GabrielLueneberg/balanceBot/CAD/Arquivos impressão/Orientação de impressão/Bases.png

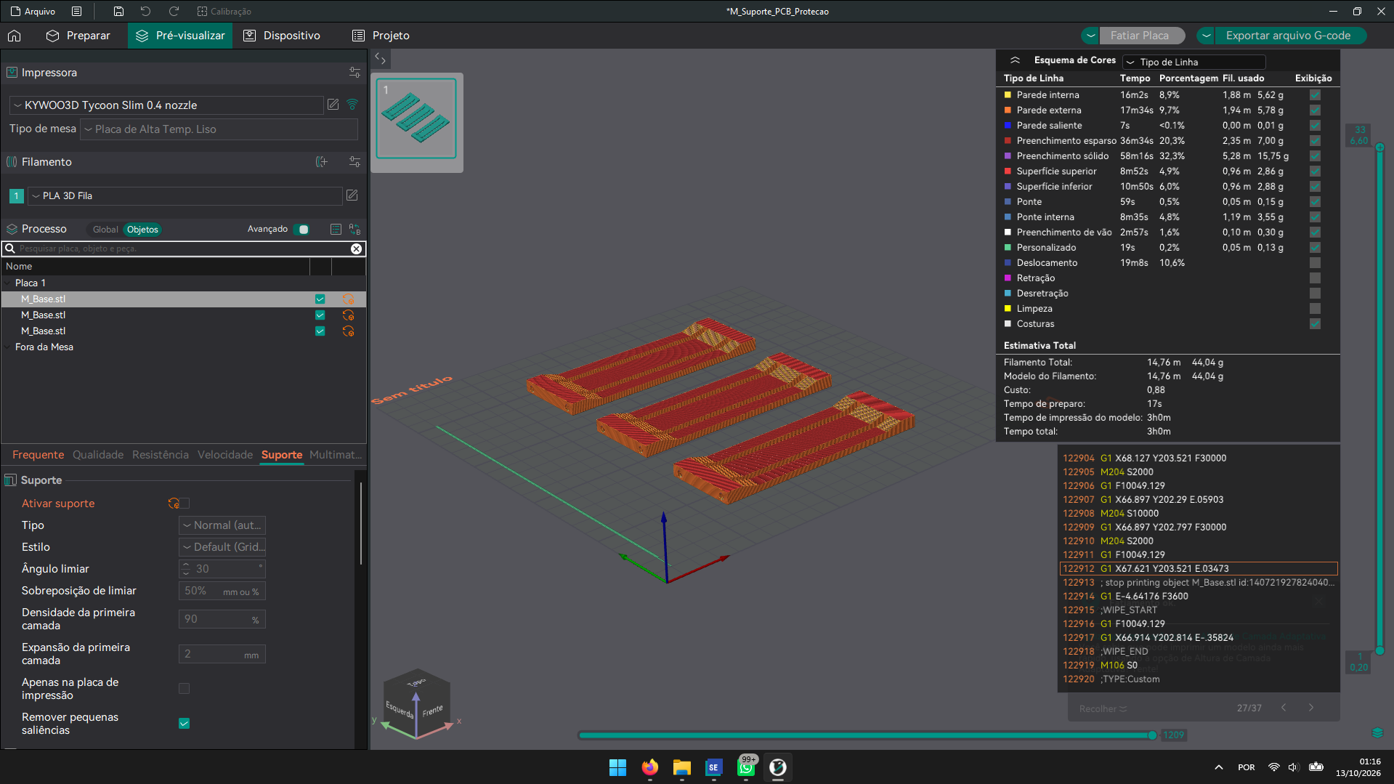
CAD/Arquivos impressão/Orientação de impressão/Bases.png
