GabrielLueneberg/balanceBot/CAD/Arquivos impressão/Orientação de impressão/Rodas e Laterais.png

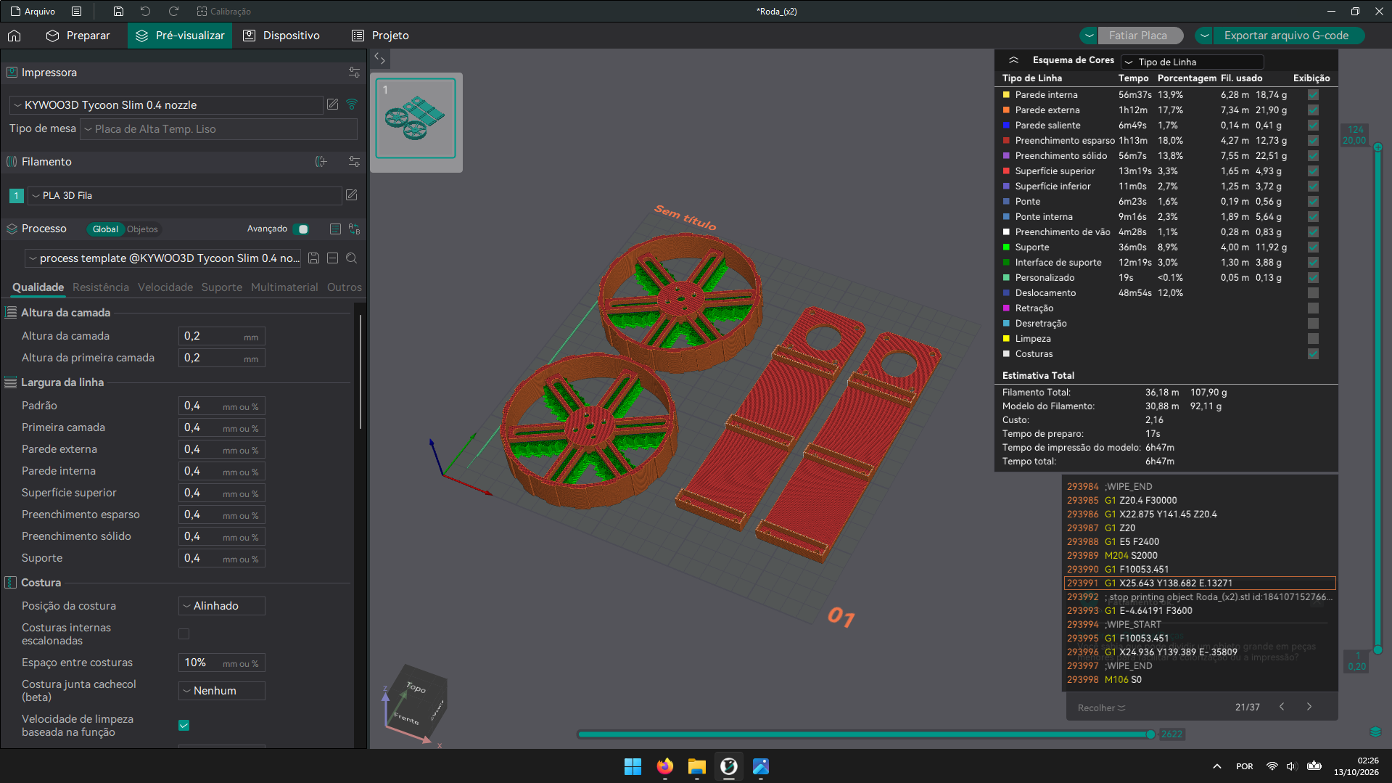
CAD/Arquivos impressão/Orientação de impressão/Rodas e Laterais.png
