GabrielLueneberg/balanceBot/CAD/Arquivos impressão/Orientação de impressão/Suporte e Suporte Com Proteção.png

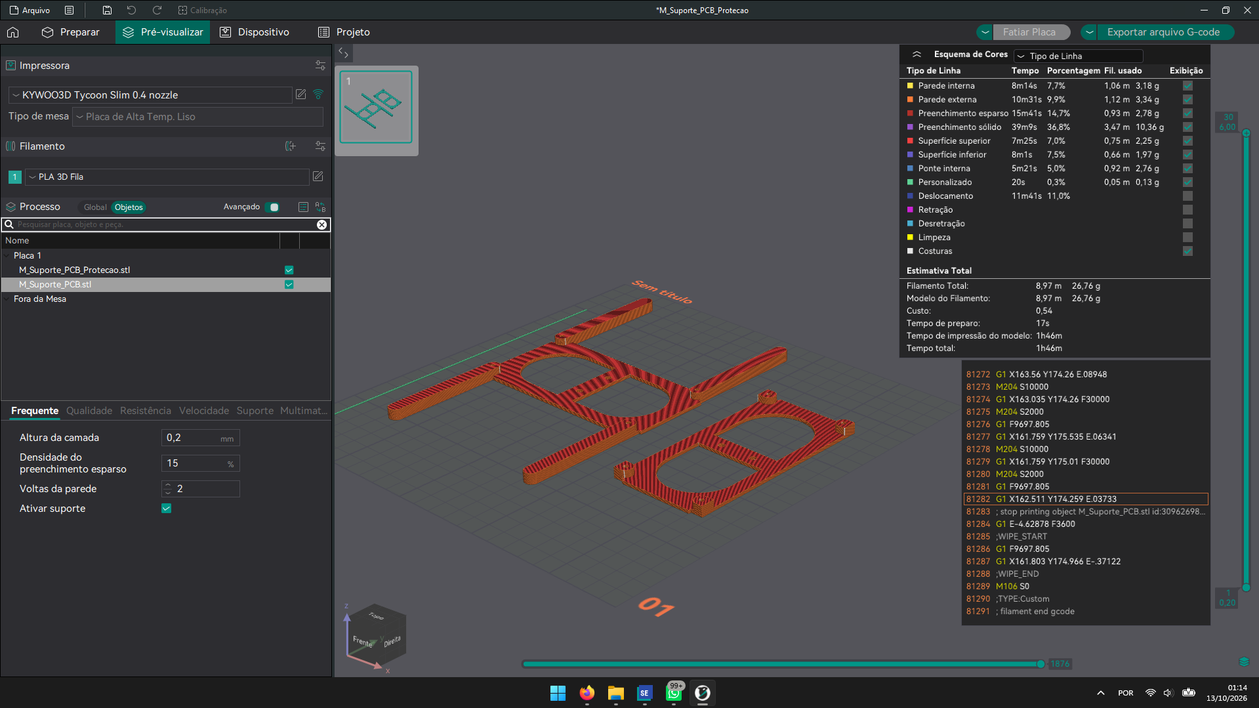
CAD/Arquivos impressão/Orientação de impressão/Suporte e Suporte Com Proteção.png
