GabrielLueneberg/balanceBot/CAD/Arquivos impressão/Arquivos STL/Roda_(x2).stl

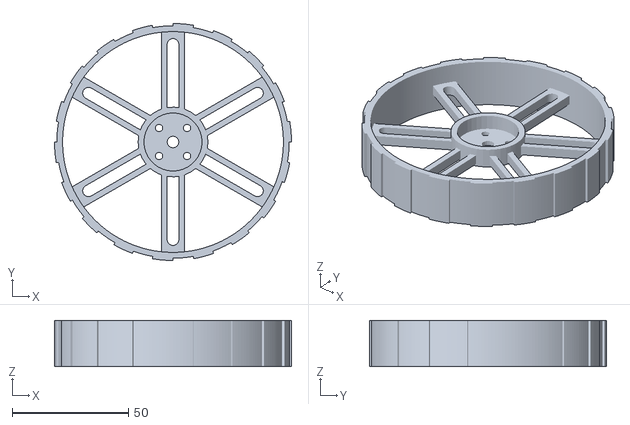
[picture p6: CAD file, 2026-11-04]
CAD/Arquivos impressão/Arquivos STL/Roda_(x2).stl
102.0 x 102.0 x 20.0
