GabrielLueneberg/balanceBot/CAD/Arquivos impressão/Arquivos STL/Lateral_(x2).stl

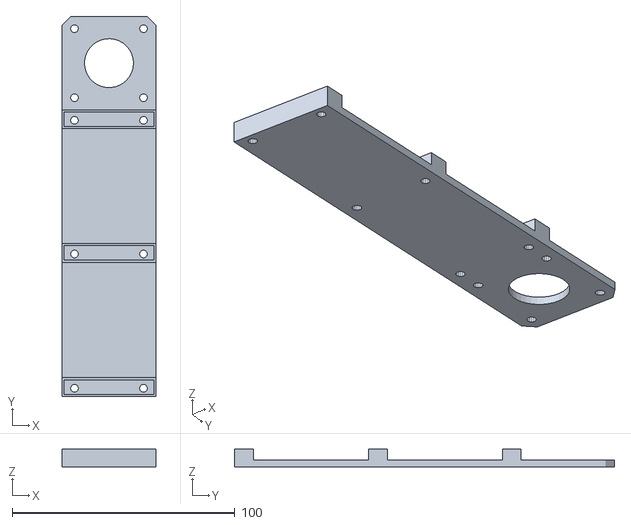
[picture p7: CAD file, 2026-11-04]
CAD/Arquivos impressão/Arquivos STL/Lateral_(x2).stl
42.3 x 170.7 x 8.00
