GabrielLueneberg/balanceBot/CAD/Arquivos impressão/Arquivos STL/Suporte_com_Protecao_(x1).stl

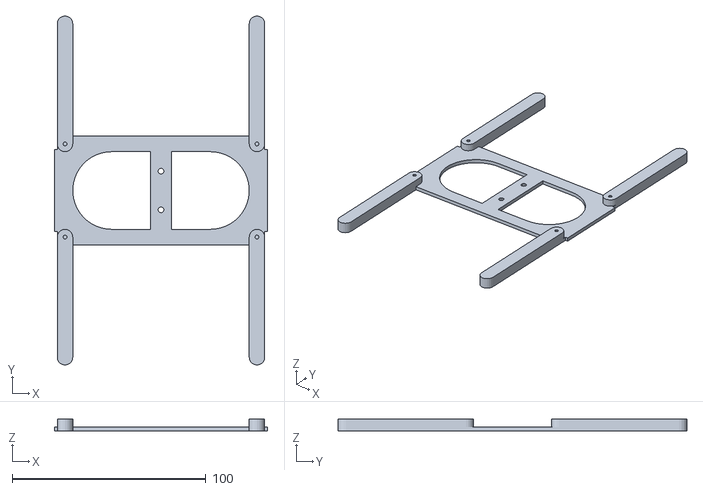
[picture p8: CAD file, 2026-11-04]
CAD/Arquivos impressão/Arquivos STL/Suporte_com_Protecao_(x1).stl
110.0 x 180.0 x 6.00
