GabrielLueneberg/balanceBot/CAD/Arquivos impressão/Arquivos STL/Base_(x3).stl

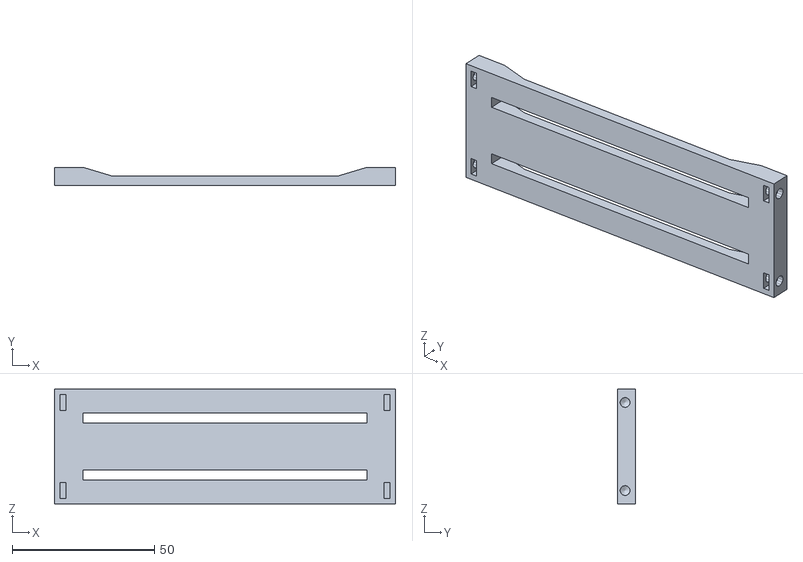
[picture p9: CAD file, 2026-11-04]
CAD/Arquivos impressão/Arquivos STL/Base_(x3).stl
120.0 x 6.50 x 40.3
