GabrielLueneberg/balanceBot/CAD/Arquivos impressão/Arquivos STL/Suporte_(x1).stl

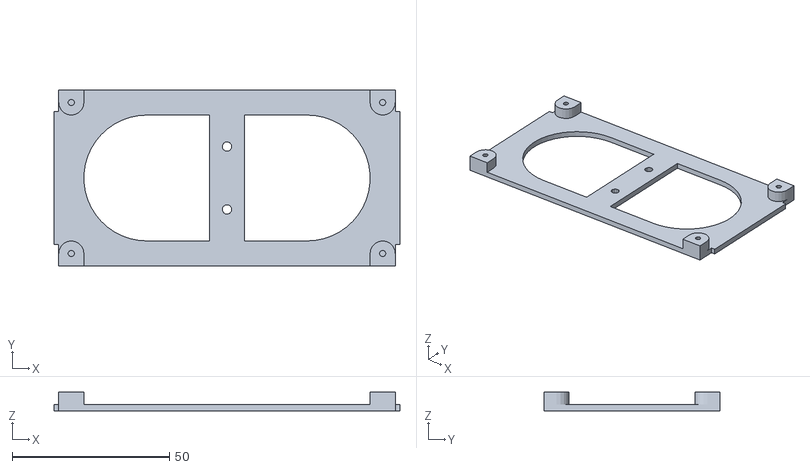
[picture p10: CAD file, 2026-11-04]
CAD/Arquivos impressão/Arquivos STL/Suporte_(x1).stl
110.0 x 56.0 x 6.00
