GabrielLueneberg/balanceBot/(commit log)

2026-11-04 Enhance README with details on chassis and motor control
    Updated the README to include additional details about the robot's modular chassis, electrical installation, and motor control mechanisms.
2026-11-04 Update README with new image and motor control details
    Updated the electrical diagram image and improved motor control explanation.
